cuspaceflight/DorMouse/PCB/Gerbers/DorMouse.GBL.png

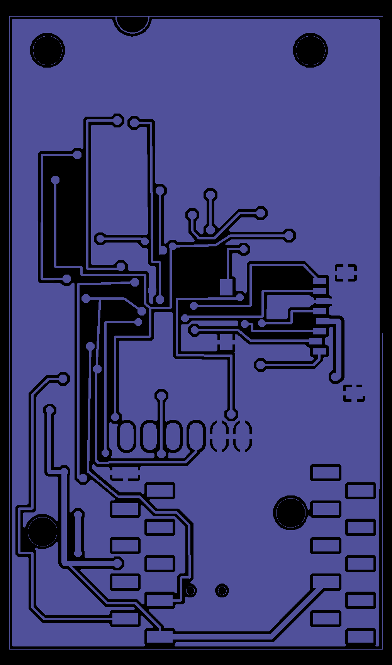
PCB/Gerbers/DorMouse.GBL.png
