cuspaceflight/DorMouse/PCB/Gerbers/DorMouse.GBS.png

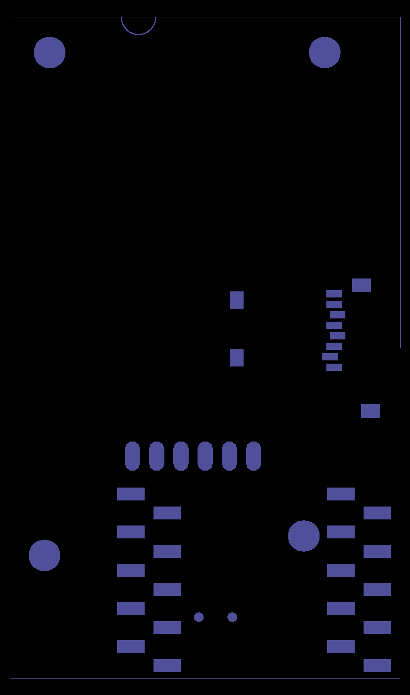
PCB/Gerbers/DorMouse.GBS.png
