cuspaceflight/DorMouse/PCB/Gerbers/DorMouse.GML.png

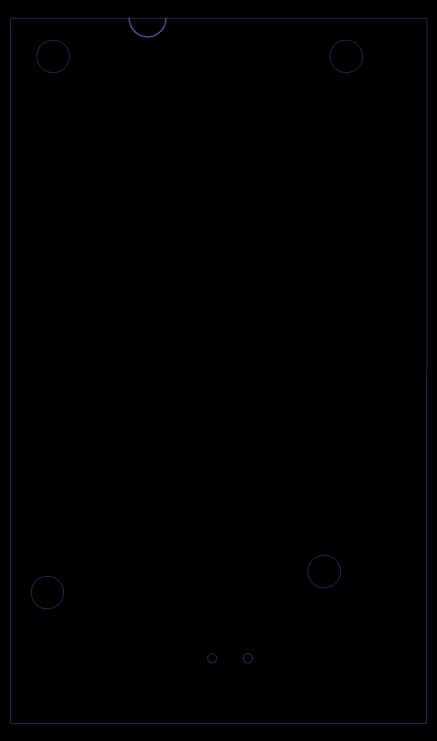
PCB/Gerbers/DorMouse.GML.png
