cuspaceflight/DorMouse/PCB/Gerbers/DorMouse.GTL.png

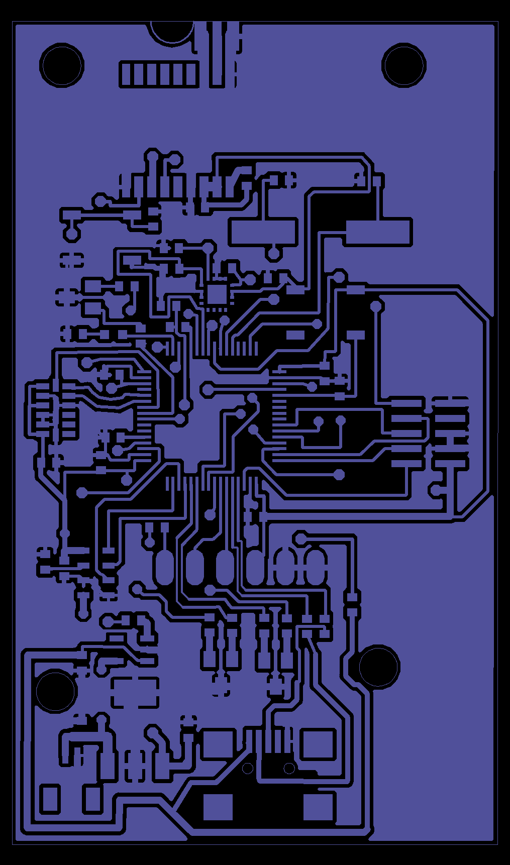
PCB/Gerbers/DorMouse.GTL.png
