cuspaceflight/DorMouse/PCB/Gerbers/DorMouse.GTO.png

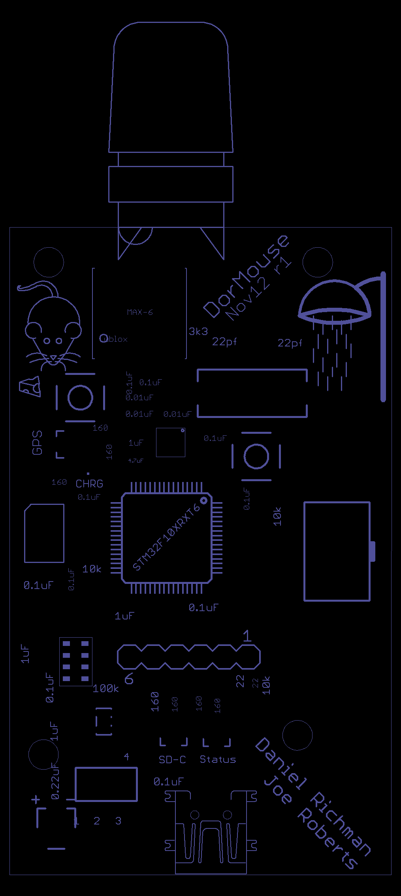
PCB/Gerbers/DorMouse.GTO.png
