cuspaceflight/DorMouse/PCB/Gerbers/DorMouse.GTS.png

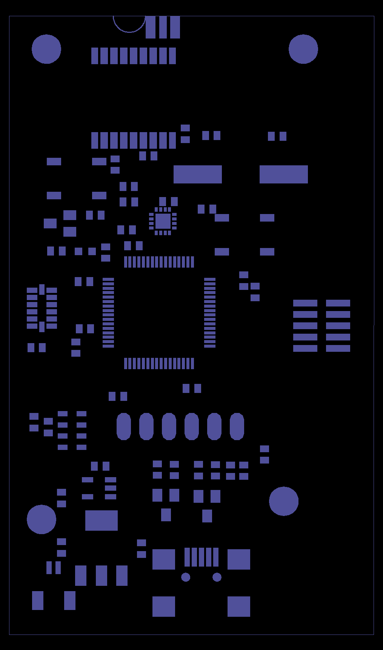
PCB/Gerbers/DorMouse.GTS.png
