cuspaceflight/DorMouse/PCB/Gerbers/DorMouse.TXT.png

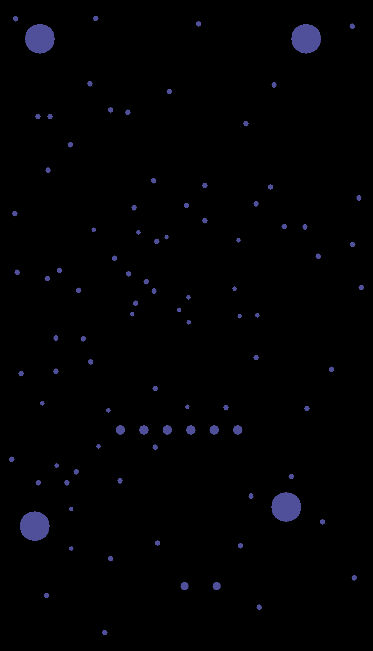
PCB/Gerbers/DorMouse.TXT.png
