cuspaceflight/DorMouse/PCB/DorMouse.brd.pdf

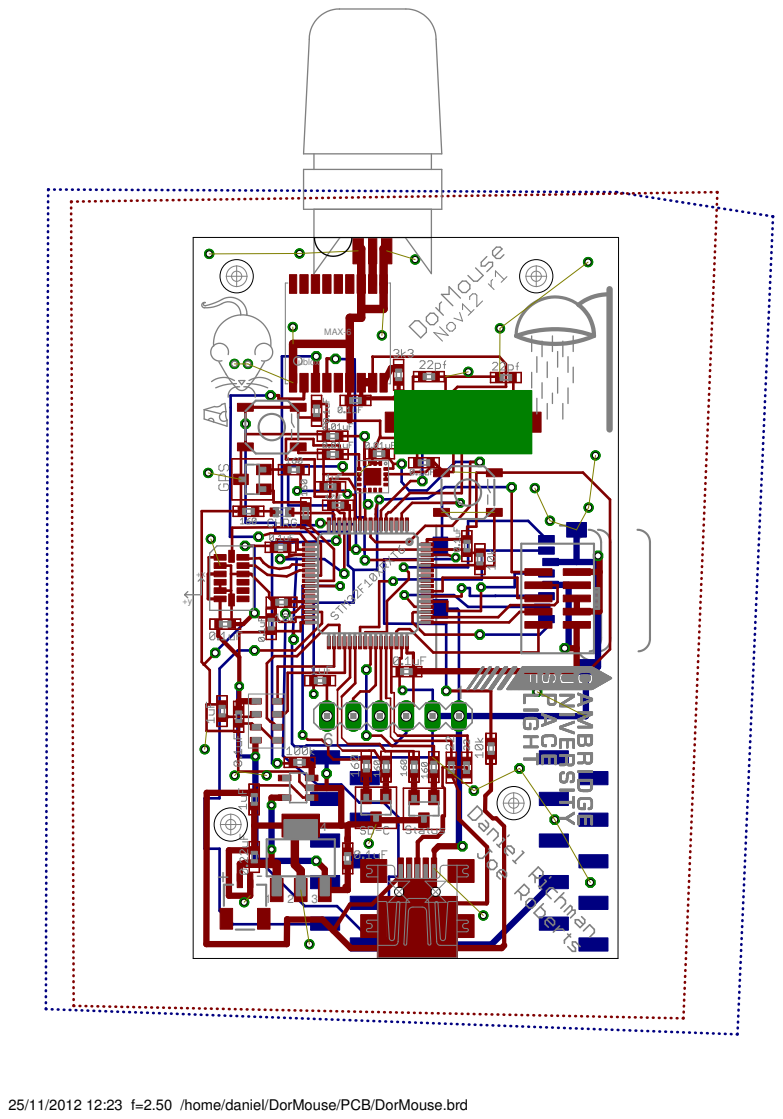
[picture p8: page 1]

25/11/2012 12:23 f=2.50 /home/daniel/DorMouse/PCB/DorMouse.brd
