cuspaceflight/DorMouse/PCB/DorMouse.brd.pour.pdf

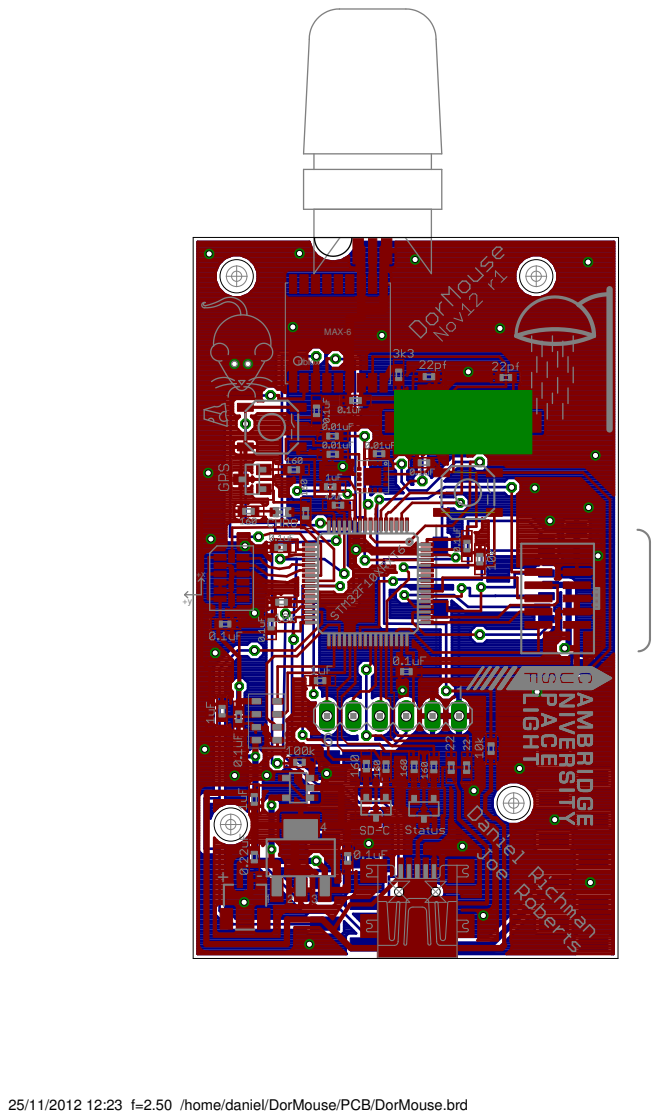
[picture p9: page 1]

25/11/2012 12:23 f=2.50 /home/daniel/DorMouse/PCB/DorMouse.brd
