cuspaceflight/DorMouse/PCB/DorMouse.sch.pdf

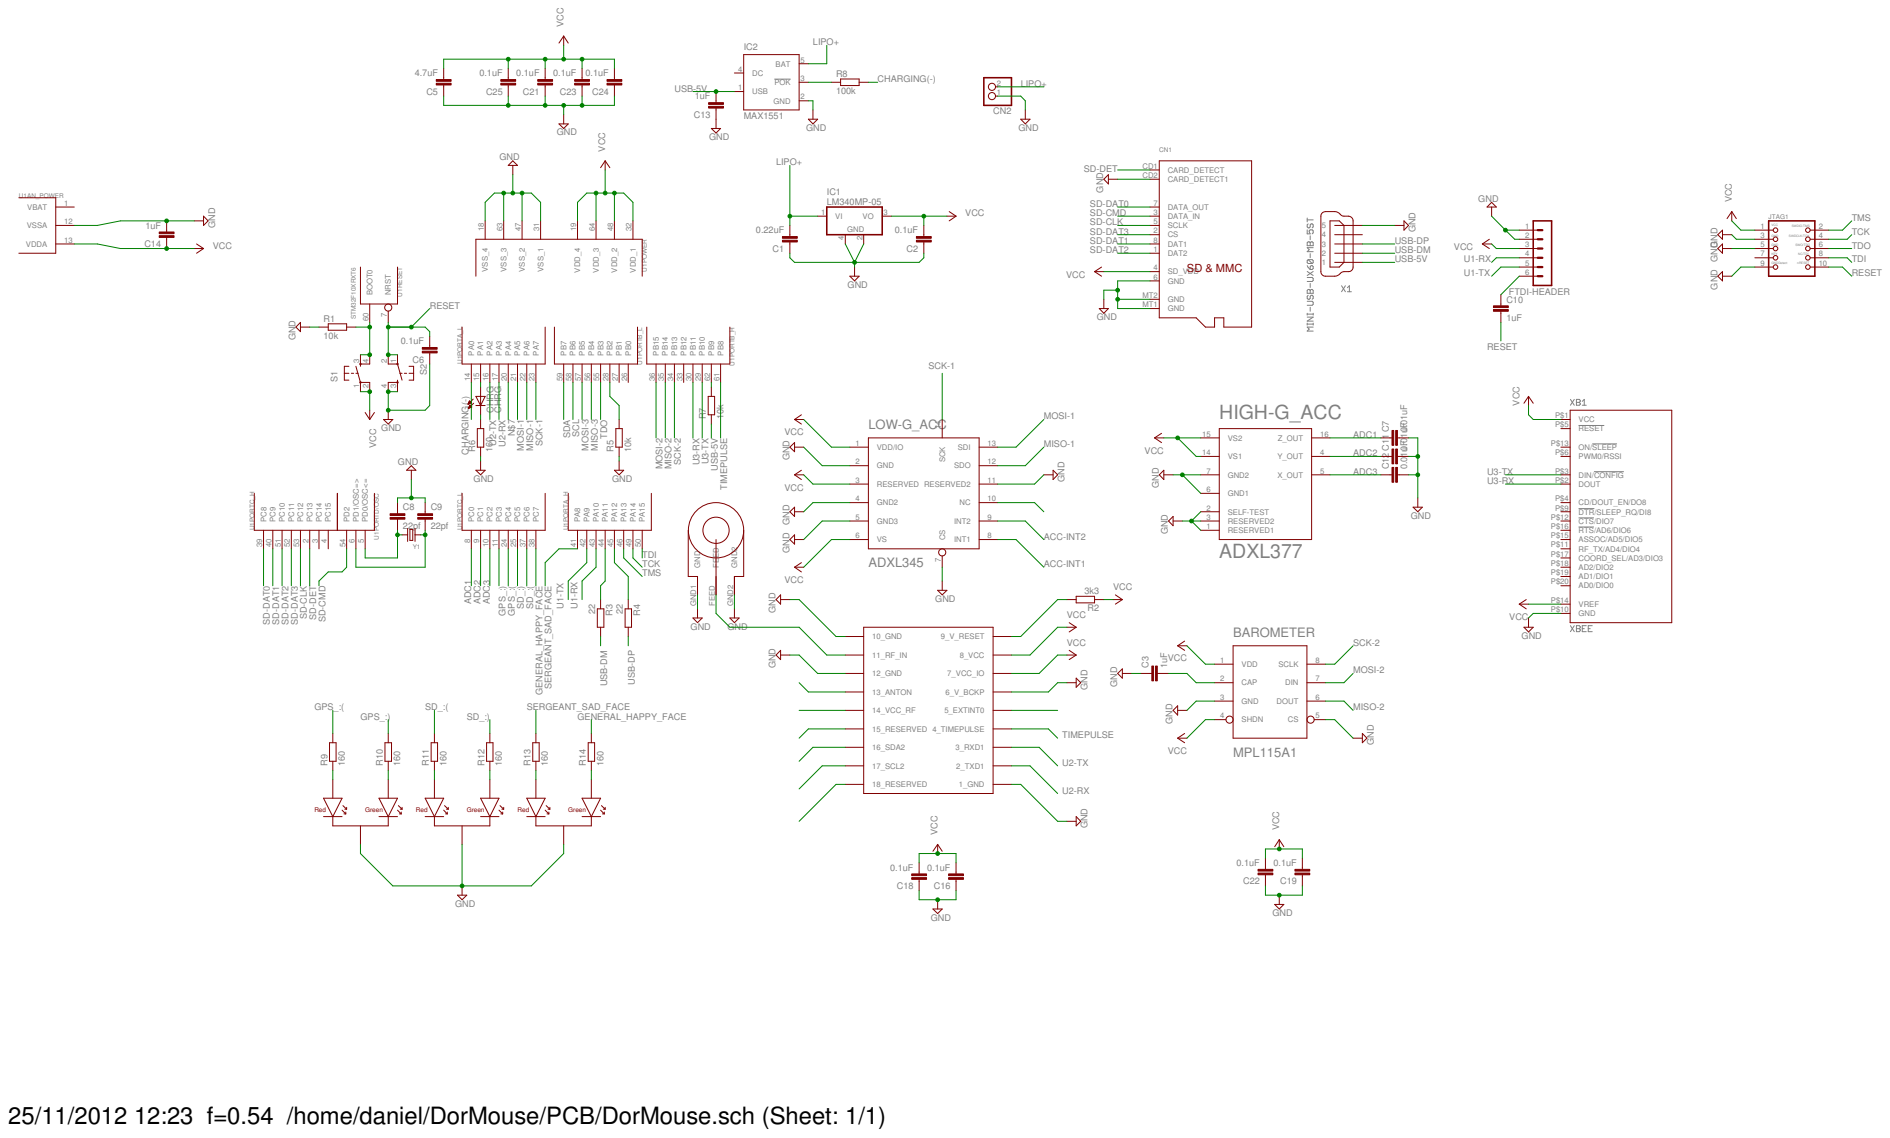
[picture p10: page 1]

nRESET NC/TDI SWO/TDO

25/11/2012 12:23 f=0.54 /home/daniel/DorMouse/PCB/DorMouse.sch (Sheet: 1/1)
