cuspaceflight/DorMouse/PCB/DorMouse.brd

## EAGLE design PCB/DorMouse.brd (2012-11-25)

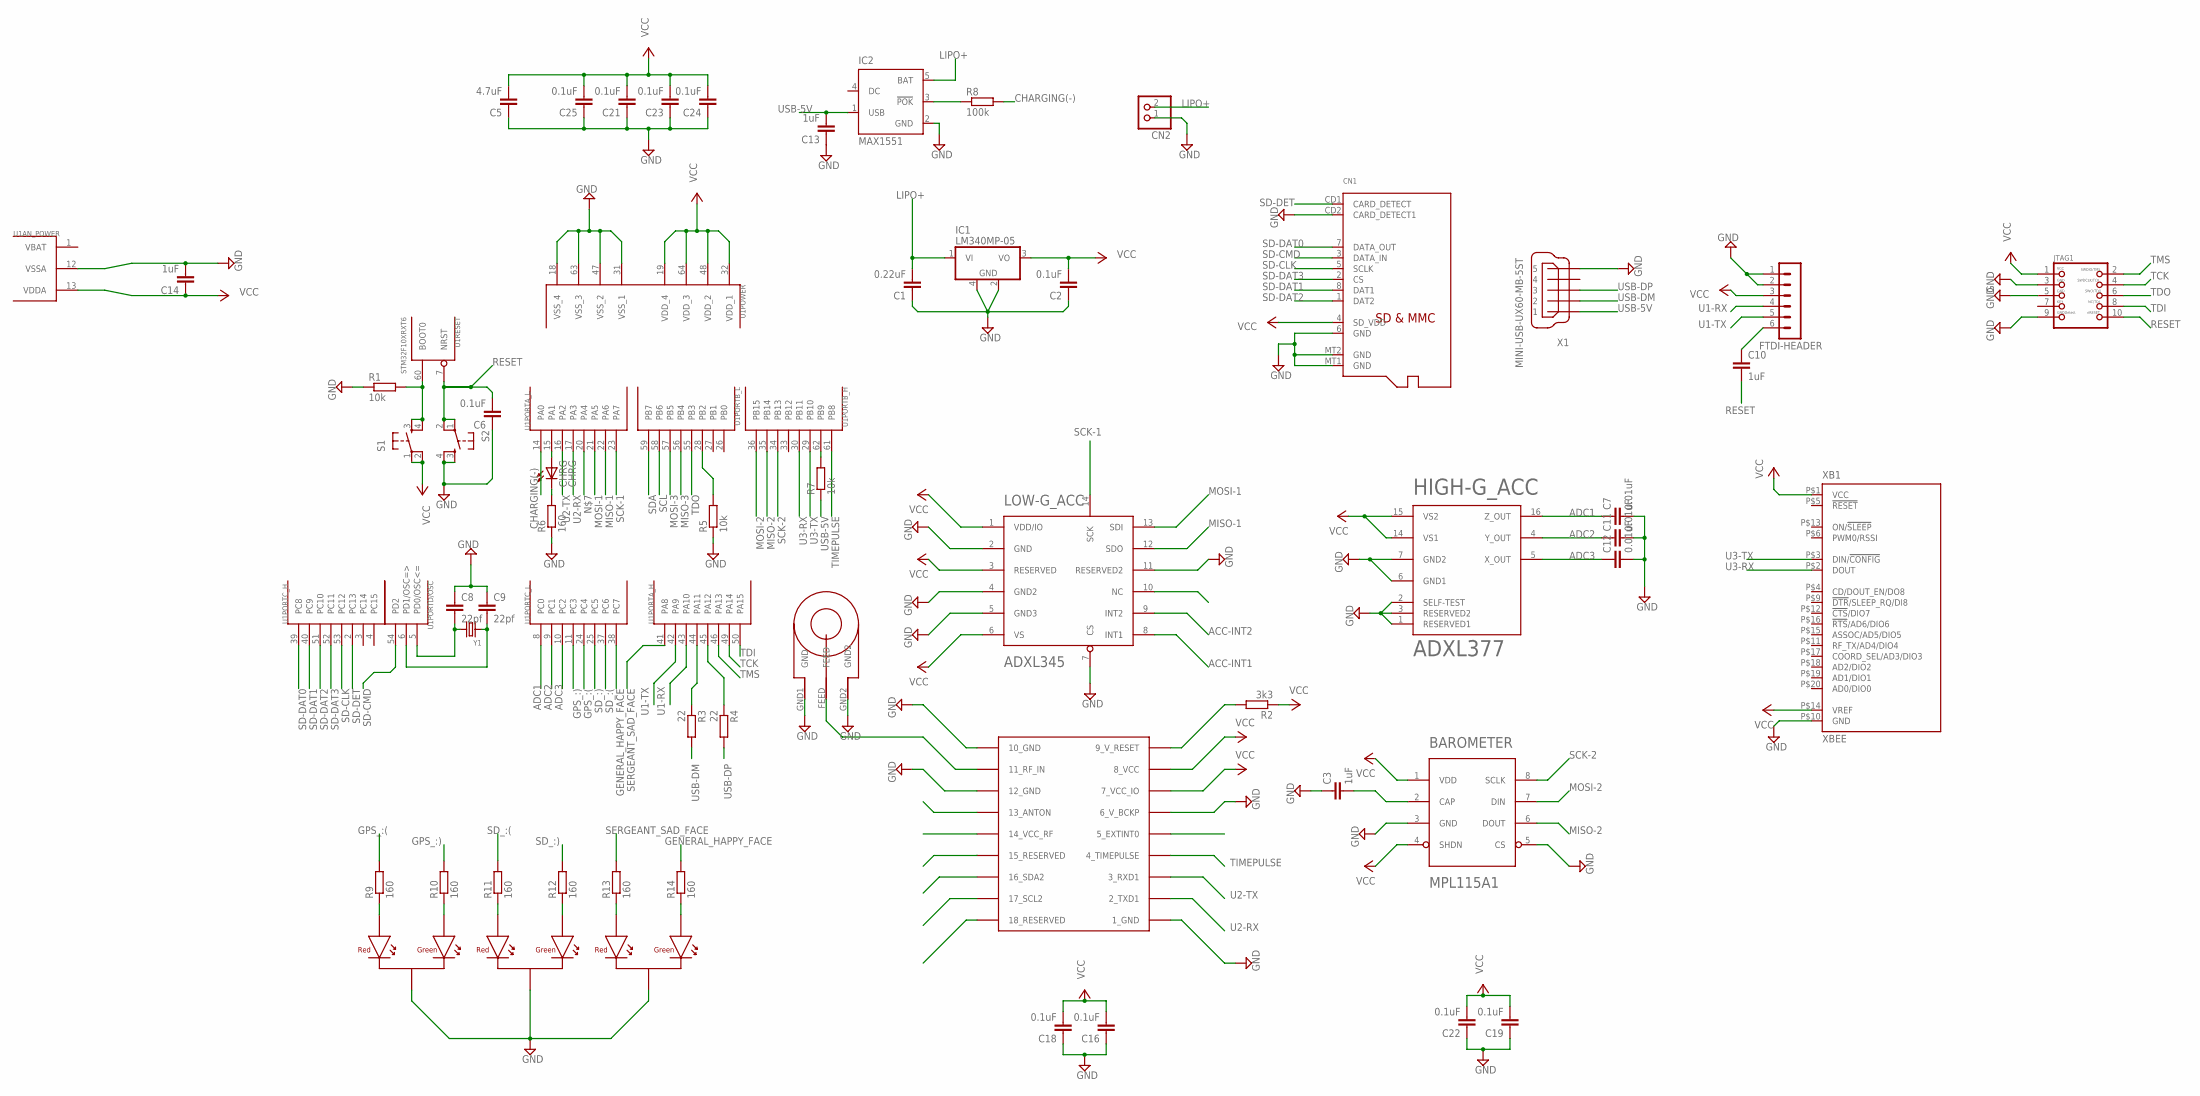
[picture p11: schematic DorMouse.sch]

Parts:
BAROMETER: MPL115A1; LGA-8
C1: 0.22uF; C0402
C2, C6, C16, C18, C19, C21, C22, C23, C24, C25: 0.1uF; C0402
C3, C10, C13, C14: 1uF; C0402
C5: 4.7uF; C0402
C7, C11, C12: 0.01uF; C0402
C8, C9: 22pf; C0402
CHRG: CHRG; CHIPLED_0603
CN1: MICROSD
CN2: JST_2PINSH2; JSTSH2
FTDI-HEADER: MA06-1
GENERAL: Status; SOT23
GPS: UBLOX_MAX-6
GPS-LED: GPS; SOT23
HIGH-G_ACC: ADXL377; LFCSP-16
IC1: LM340MP-05; SOT223
IC2: MAX1551; SOT23-5L
JTAG1: JTAG-CORTEXM3; 2X05_1.27MM_SMT
LOW-G_ACC: ADXL345; LGA-14
R1, R5, R7: 10k; R0402
R2: 3k3; R0402
R3, R4: 22; R0402
R6, R9, R10, R11, R12, R13, R14: 160; R0402
R8: 100k; R0402
S1, S2: TAC_SWITCHSMD; TACTILE_SWITCH_SMD
SD-LED: SD-C; SOT23
U1: STM32F10XRXT6; TQFP64
U$1: SARANTEL-SR1202
X1: MINI-USB-UX60-MB-5ST; UX60-MB-5ST
XB1: XBEE
Y1: CRYSTALSMD; HC49UP

Connections:
ACC-INT1: LOW-G_ACC.8 (INT1)
ACC-INT2: LOW-G_ACC.9 (INT2)
ADC1: C7.1, HIGH-G_ACC.16 (Z_OUT), U1.8 (PC0)
ADC2: C11.1, HIGH-G_ACC.4 (Y_OUT), U1.9 (PC1)
ADC3: C12.1, HIGH-G_ACC.5 (X_OUT), U1.10 (PC2)
BOOT1: R5.2, U1.28 (PB2)
CHARGING(-): R8.2, U1.14 (PA0)
GENERAL_HAPPY_FACE: R14.2, U1.38 (PC7)
GND: BAROMETER.3 (GND), BAROMETER.5 (CS), C1.1, C2.1, C3.1, C5.1, C6.1, C7.2, C8.1, C9.1, C11.2, C12.2, C13.1, C14.2, C16.1, C18.1, C19.1, C21.1, C22.1, C23.1, C24.1, C25.1, CN1.6 (GND), CN1.CD2 (CARD_DETECT1), CN1.MT1 (GND), CN1.MT2 (GND), CN2.1, FTDI-HEADER.1, FTDI-HEADER.2, GENERAL.3 (CATHODE), GPS.1_GND, GPS.6_V_BCKP, GPS.10_GND, GPS.12_GND, GPS-LED.3 (CATHODE), HIGH-G_ACC.1 (RESERVED1), HIGH-G_ACC.2 (SELF-TEST), HIGH-G_ACC.3 (RESERVED2), HIGH-G_ACC.6 (GND1), HIGH-G_ACC.7 (GND2), IC1.2 (GND1), IC1.4 (GND), IC2.2 (GND), JTAG1.3, JTAG1.5, JTAG1.9, LOW-G_ACC.2 (GND), LOW-G_ACC.4 (GND2), LOW-G_ACC.5 (GND3), LOW-G_ACC.7 (CS), LOW-G_ACC.11 (RESERVED2), R1.1, R5.1, R6.1, S2.3, S2.4, SD-LED.3 (CATHODE), U1.12 (VSSA), U1.18 (VSS_4), U1.31 (VSS_1), U1.47 (VSS_2), U1.63 (VSS_3), U$1.GND1 (GND), U$1.GND2, X1.5, XB1.P$10 (GND)
GPS_:(: R9.2, U1.24 (PC4)
GPS_:): R10.2, U1.11 (PC3)
LIPO+: C1.2, CN2.2, IC1.1 (VI), IC2.5 (BAT)
MISO-1: LOW-G_ACC.12 (SDO), U1.22 (PA6)
MISO-2: BAROMETER.6 (DOUT), U1.35 (PB14)
MISO-3: U1.56 (PB4)
MOSI-1: LOW-G_ACC.13 (SDI), U1.21 (PA5)
MOSI-2: BAROMETER.7 (DIN), U1.36 (PB15)
MOSI-3: U1.57 (PB5)
unnamed: R1.2, S1.3, S1.4, U1.60 (BOOT0)
unnamed: BAROMETER.2 (CAP), C3.2
unnamed: R3.1, U1.44 (PA11)
unnamed: C9.2, U1.6 (PD1/OSC=>), Y1.1
unnamed: R4.1, U1.45 (PA12)
unnamed: CHRG.A, U1.15 (PA1)
unnamed: CHRG.C, R6.2
unnamed: IC2.3 (!POK), R8.1
unnamed: C8.2, U1.5 (PD0/OSC<=), Y1.2
unnamed: GPS.9_V_RESET, R2.2
unnamed: GPS-LED.1 (RED-ANODE), R9.1
unnamed: GPS.11_RF_IN, U$1.FEED
unnamed: C10.1, FTDI-HEADER.6
unnamed: R7.2, U1.62 (PB9)
unnamed: GPS-LED.2 (GREEN-ANODE), R10.1
unnamed: R11.1, SD-LED.1 (RED-ANODE)
unnamed: R12.1, SD-LED.2 (GREEN-ANODE)
unnamed: GENERAL.1 (RED-ANODE), R13.1
unnamed: GENERAL.2 (GREEN-ANODE), R14.1
RESET: C6.2, C10.2, JTAG1.10, S2.1, S2.2, U1.7 (NRST)
SCK-1: LOW-G_ACC.14 (SCK), U1.23 (PA7)
SCK-2: BAROMETER.8 (SCLK), U1.34 (PB13)
SCL: U1.58 (PB6)
SD-CLK: CN1.5 (SCLK), U1.53 (PC12)
SD-CMD: CN1.3 (DATA_IN), U1.54 (PD2)
SD-DAT0: CN1.7 (DATA_OUT), U1.39 (PC8)
SD-DAT1: CN1.8 (DAT1), U1.40 (PC9)
SD-DAT2: CN1.1 (DAT2), U1.51 (PC10)
SD-DAT3: CN1.2 (CS), U1.52 (PC11)
SD-DET: CN1.CD1 (CARD_DETECT), U1.2 (PC13)
SDA: U1.59 (PB7)
SD_:(: R11.2, U1.37 (PC6)
SD_:): R12.2, U1.25 (PC5)
SERGEANT_SAD_FACE: R13.2, U1.41 (PA8)
TCK: JTAG1.4, U1.49 (PA14)
TDI: JTAG1.8, U1.50 (PA15)
TDO: JTAG1.6, U1.55 (PB3)
TIMEPULSE: GPS.4_TIMEPULSE, U1.61 (PB8)
TMS: JTAG1.2, U1.46 (PA13)
U1-RX: FTDI-HEADER.4, U1.43 (PA10)
U1-TX: FTDI-HEADER.5, U1.42 (PA9)
U2-RX: GPS.2_TXD1, U1.17 (PA3)
U2-TX: GPS.3_RXD1, U1.16 (PA2)
U3-RX: U1.30 (PB11), XB1.P$2 (DOUT)
U3-TX: U1.29 (PB10), XB1.P$3 (DIN/!CONFIG)
USB-5V: C13.2, IC2.1 (USB), R7.1, X1.1
USB-DM: R3.2, X1.2
USB-DP: R4.2, X1.3
VBAT: U1.1 (VBAT)
VCC: BAROMETER.1 (VDD), BAROMETER.4 (SHDN), C2.2, C5.2, C14.1, C16.2, C18.2, C19.2, C21.2, C22.2, C23.2, C24.2, C25.2, CN1.4 (SD_VDD), FTDI-HEADER.3, GPS.7_VCC_IO, GPS.8_VCC, HIGH-G_ACC.14 (VS1), HIGH-G_ACC.15 (VS2), IC1.3 (VO), JTAG1.1, LOW-G_ACC.1 (VDD/IO), LOW-G_ACC.3 (RESERVED), LOW-G_ACC.6 (VS), R2.1, S1.1, S1.2, U1.13 (VDDA), U1.19 (VDD_4), U1.32 (VDD_1), U1.48 (VDD_2), U1.64 (VDD_3), XB1.P$1 (VCC), XB1.P$14 (VREF)

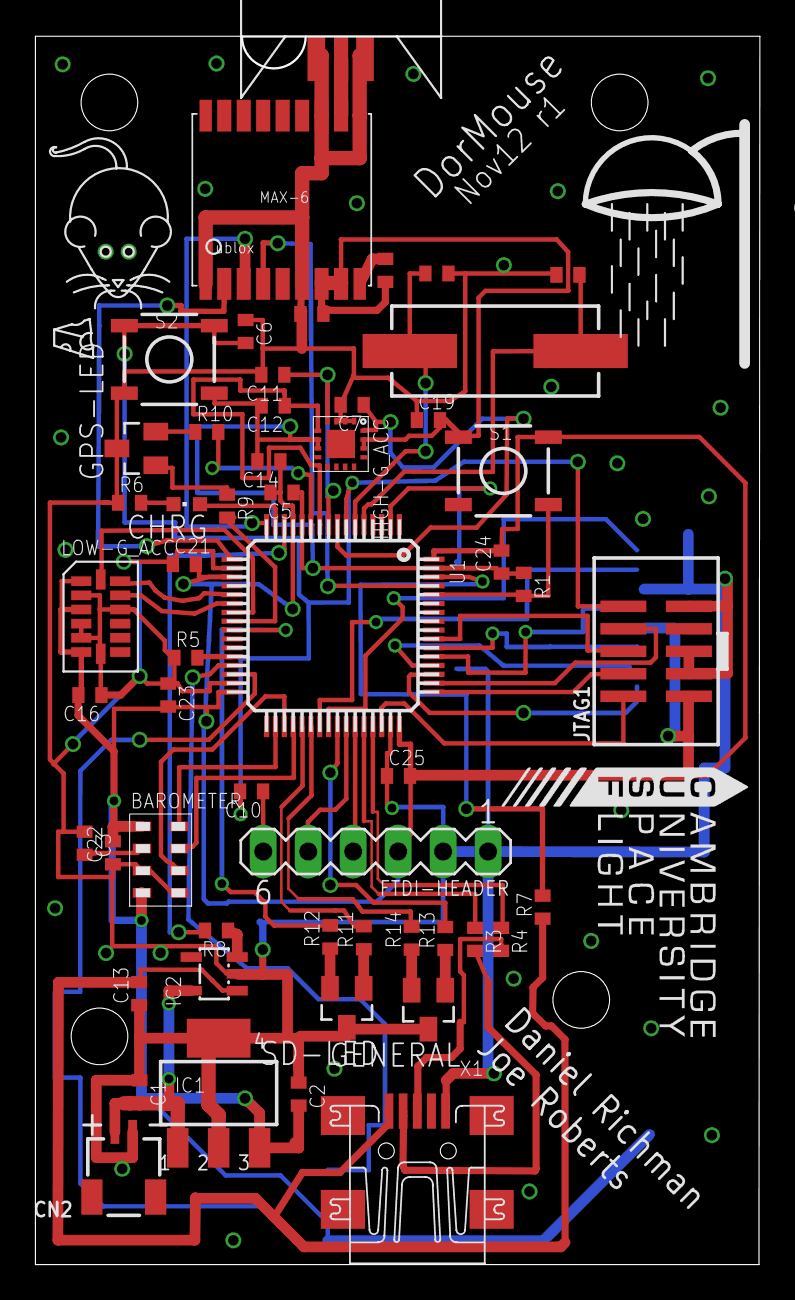
[picture p12: board DorMouse.brd from above]

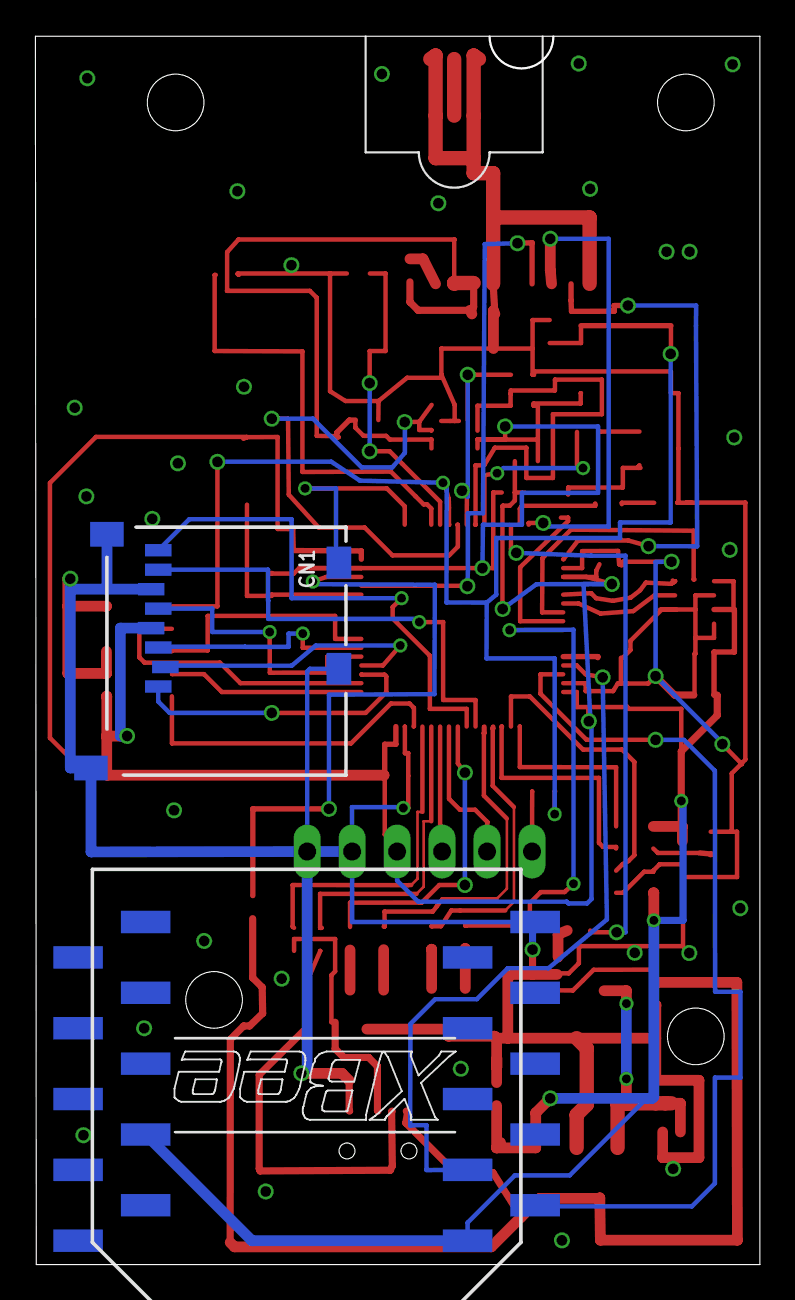
[picture p13: board DorMouse.brd from below]

Board: 2 copper layers, 40.9 x 69.4 mm, 59 parts (2 on the bottom side), 61 nets.

Other parts of the board:
U$2: SHOWER
U$3: DORMOUSE
U$4: CUSF_LOGO
