cuspaceflight/DorMouse/misc/ublox_ack.py

msg = [0xB5, 0x62, 0x06, 0x24, 0x24, 0x00, 0xFF, 0xFF, 0x06, 0x03, 0x00,
       0x00, 0x00, 0x00, 0x10, 0x27, 0x00, 0x00, 0x05, 0x00, 0xFA, 0x00,
       0xFA, 0x00, 0x64, 0x00, 0x2C, 0x01, 0x00, 0x00, 0x00, 0x00, 0x00,
       0x00, 0x00, 0x00, 0x00, 0x00, 0x00, 0x00, 0x00, 0x00, 0x16, 0xDC]

msg = [0xB5, 0x62, 0x06, 0x24, 0x24, 0x00, 0x05, 0x00, 0x08, 0x03, 0x00,
       0x00, 0x00, 0x00, 0x00, 0x00, 0x00, 0x00, 0x00, 0x00, 0x00, 0x00,
       0x00, 0x00, 0x00, 0x00, 0x00, 0x00, 0x00, 0x00, 0x00, 0x00, 0x00,
       0x00, 0x00, 0x00, 0x00, 0x00, 0x00, 0x00, 0x00, 0x00, 0x00, 0x00]

msg = [0xB5, 0x62, 0x05, 0x01, 0x02, 0x00, 0x05, 0x24, 0x00, 0x00]

ck_a = ck_b = 0

for c in msg[2:-2]:
    ck_a = (ck_a + c) & 255
    ck_b = (ck_b + ck_a) & 255

print ck_a, ck_b
print msg[-2], msg[-1]
