cuspaceflight/DorMouse/(commit log)

2012-11-23 Silkscreen work: values and mice
    [DorMouse.brd, DorMouse.sch]
2012-11-23 Gerbers run
    [DorMouse.GBL, DorMouse.GBO, DorMouse.GBP, DorMouse.GBS, DorMouse.GTL, DorMouse.GTO, DorMouse.GTP, DorMouse.GTS]
2012-11-23 CUSF Logo
    [DorMouse.brd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]
2012-11-24 Add mounting holes
    [DorMouse.brd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]
2012-11-24 Add labels for GPS
    [DorMouse.brd, DorMouse.sch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]
2012-11-25 Connect pad 2 of LDO reg to GND
    [DorMouse.brd, DorMouse.sch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]
2012-11-29 sd led, general led
2012-11-30 Actually switch spi on
2012-11-30 debug. timer fixes. misc stuff
    [accel_lowg.c, baro.c, debug.c, debug.h, gps.c, leds.c, main.c]
